SeverinDavis/sevmode-kl46z/README.txt

This is a Subversion repository; use the 'svnadmin' tool to examine
it.  Do not add, delete, or modify files here unless you know how
to avoid corrupting the repository.

Visit http://subversion.apache.org/ for more information.
