SeverinDavis/sevmode-kl46z/Drawings/top_drawing.png

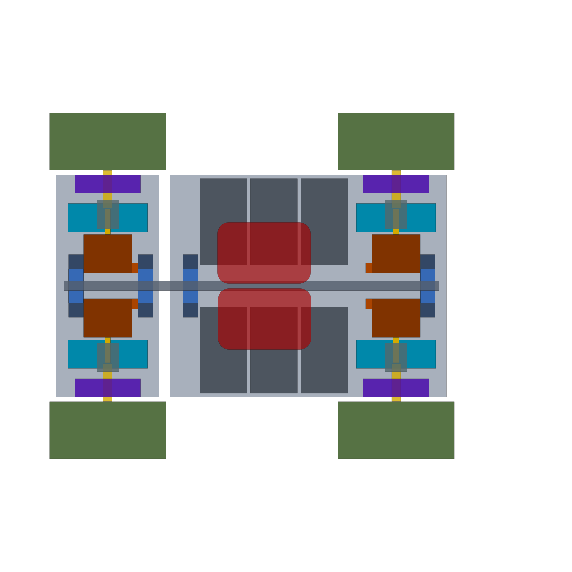
Drawings/top_drawing.png
