SeverinDavis/sevmode-kl46z/Kicad/car_v3.kicad_pcb

## KiCad design Kicad/car_v3.kicad_pcb (2014-08-28)

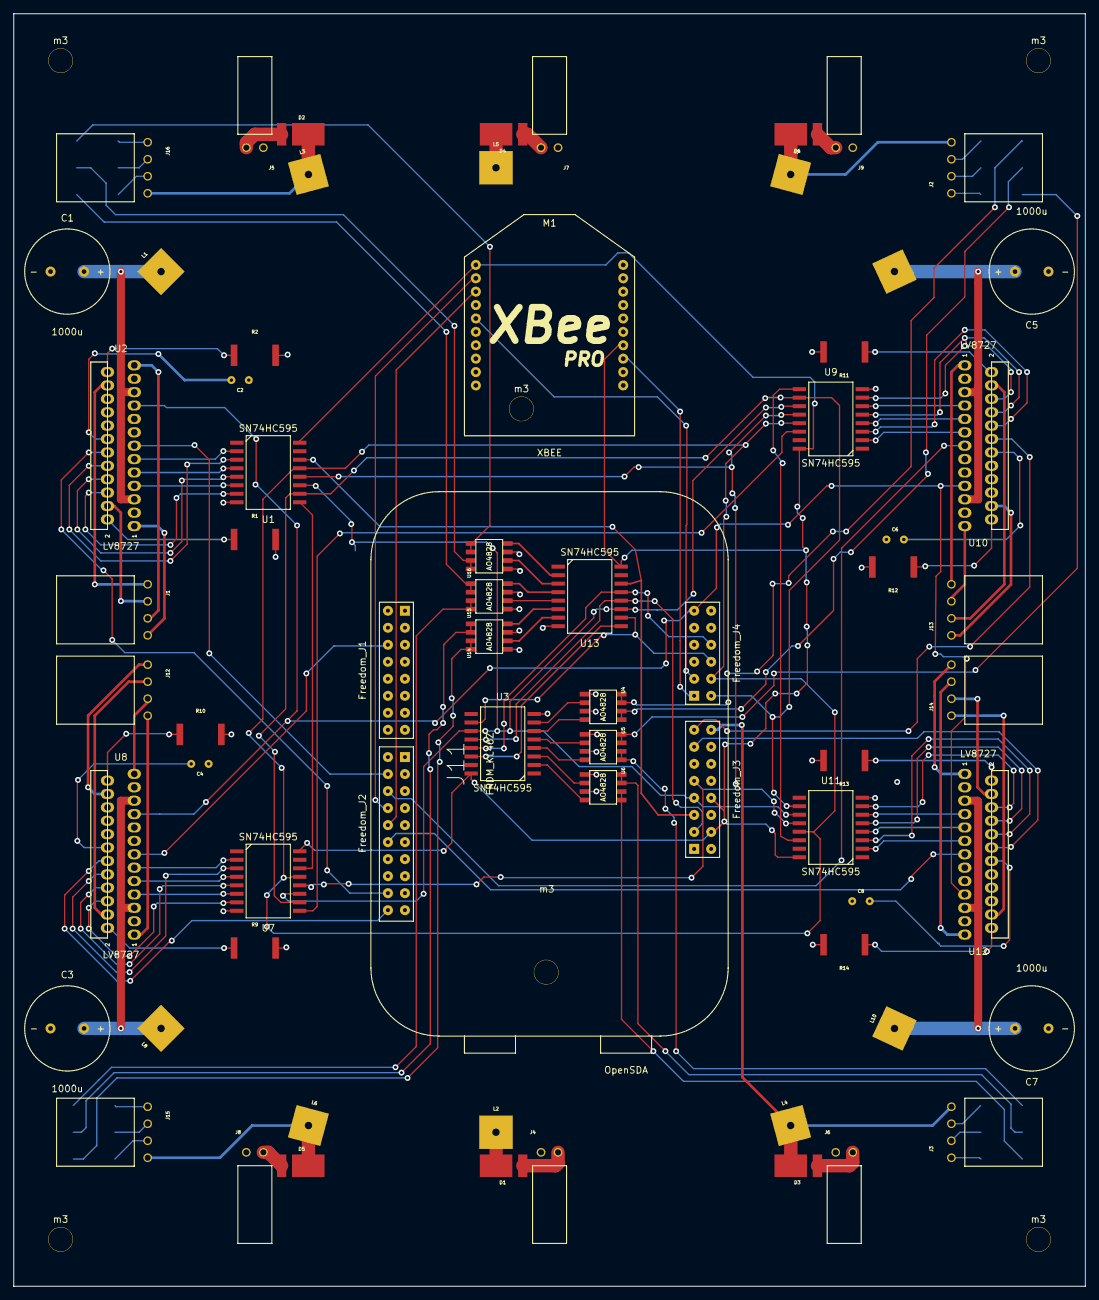
[picture p20: board car_v3.kicad_pcb from above]

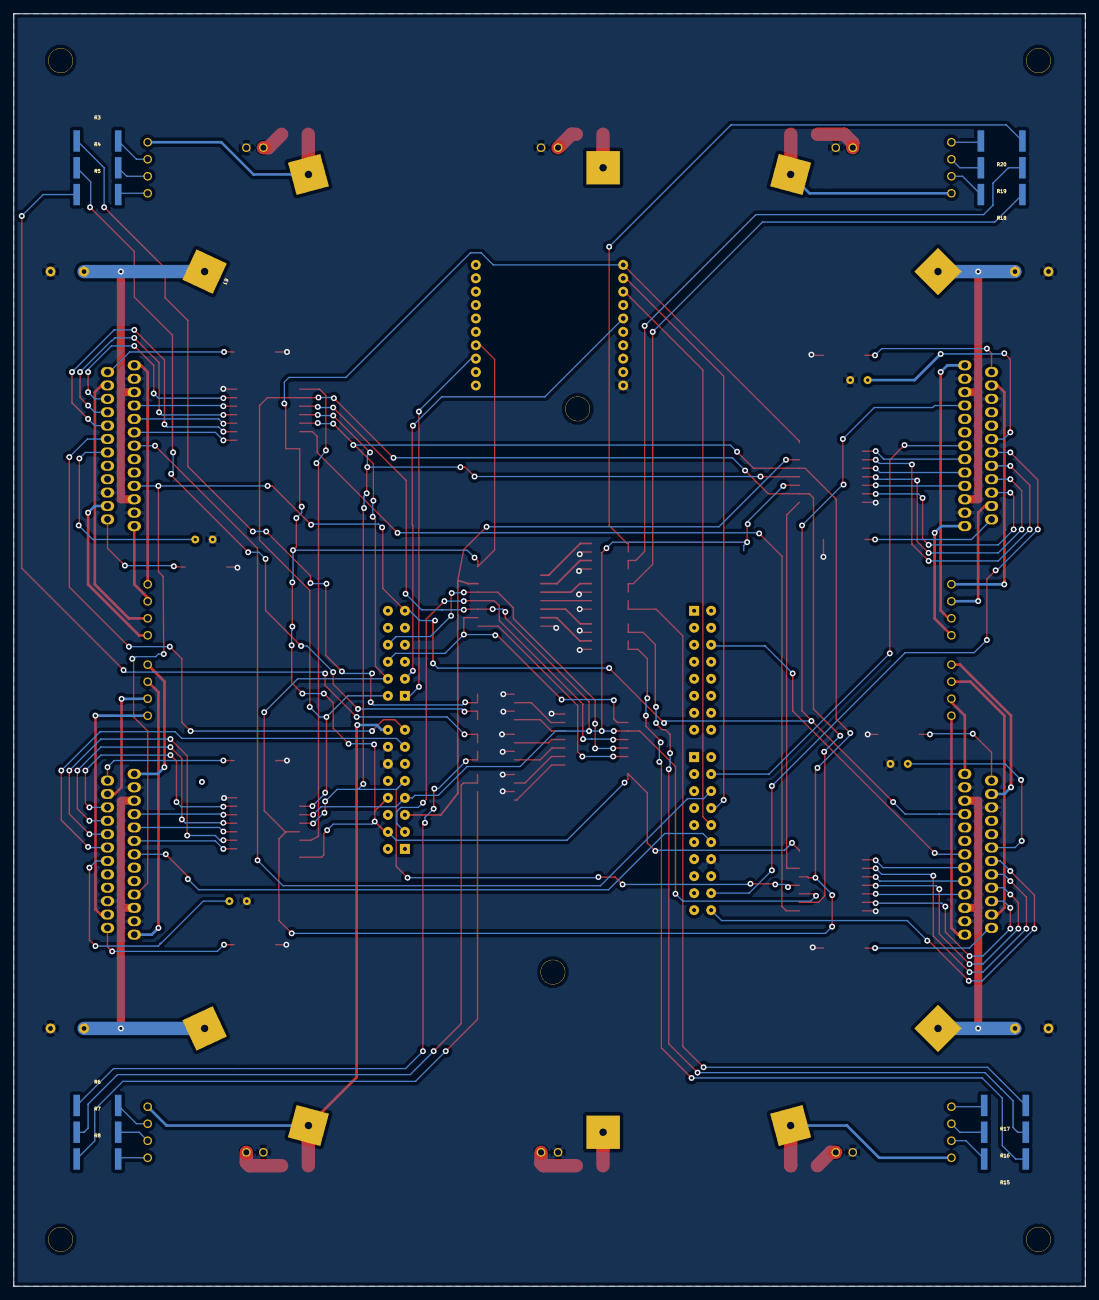
[picture p21: board car_v3.kicad_pcb from below]

Board: 2 copper layers, 160.0 x 190.0 mm, 82 parts (13 on the bottom side), 126 nets.

Parts:
C1, C3, C5, C7: 1000u; CAP_1000uF
C2, C4, C6, C8: 180p; __CAP_180p
D1, D2, D3, D4, D5, D6: POWER_DIODE; __POWERDI5
J1, J12, J13, J14: CONN_MOTOR; __4P_CONNECTOR
J2, J3, J15, J16: CONN_LED; __4P_CONNECTOR
J4, J5, J6, J7, J8, J9: CONN2; __2P_CONNECTOR
J11: FRDM_KL46Z; __Freedom
L1, L2, L3, L4, L5, L6, L7, L8, L9, L10: LUG; __LUG
M1: XBEE; __XBeePro
R1, R2, R9, R10, R11, R12, R13, R14: 0.27; _RES
R3, R6, R15, R18: 300; _RES
R4, R5, R7, R8, R16, R17, R19, R20: 249; _RES
U1, U3, U7, U9, U11, U13: SN74HC595; __SN74HC595
U2, U8, U10, U12: LV8727; __LV8728
U4, U5, U6, U14, U15, U16: AO4828; __AO4828
m3, m3#2, m3#3, m3#4, m3#5, m3#6: __m3

Connections:
+3.3V: J11.304, J11.308, M1.1, M1.14, U1.16, U3.16, U7.16, U9.16, U11.16, U13.16
+8V: D1.2, D2.2, D3.2, D4.2, D5.2, D6.2, J2.1, J3.1, J11.316, J15.1, J16.1, L2.1, L3.1, L4.1, L5.1, L6.1, L7.1
/KL46Z_DUAL/L_OE_b: J11.408, U3.13, U13.13
/KL46Z_DUAL/L_SRCLR_b: J11.406, U3.10, U13.10
/KL46Z_DUAL/M0_STEP: J11.204, U2.13
/KL46Z_DUAL/M1_STEP: J11.106, U8.13
/KL46Z_DUAL/M2_STEP: J11.206, U10.13
/KL46Z_DUAL/M3_STEP: J11.212, U12.13
/KL46Z_DUAL/M_OE_b: J11.404, U1.13, U7.13, U9.13, U11.13
/KL46Z_DUAL/M_SRCLR_b: J11.402, U1.10, U7.10, U9.10, U11.10
/KL46Z_DUAL/M_VREF: J11.411, U2.19, U8.19, U10.19, U12.19
/KL46Z_DUAL/SCL: J11.307, U1.11, U3.11, U7.11, U9.11, U11.11, U13.11
/KL46Z_DUAL/SDATA: J11.305, U1.14, U13.14
/LED_DUAL_DRIVER0/CS: J11.303, U3.12, U13.12
/LED_DUAL_DRIVER1/SDIN: U3.14, U13.9
/MOTOR0/CS: J11.309, U1.12, U7.12, U9.12, U11.12
/MOTOR0/FR: J11.218, U2.12
/MOTOR1/FR: J11.220, U8.12
/MOTOR1/SDIN: U1.9, U7.14
/MOTOR2/FR: J11.315, U10.12
/MOTOR2/SDIN: U7.9, U9.14
/MOTOR3/FR: J11.313, U12.12
/MOTOR3/SDIN: U9.9, U11.14
/XBEE0/ON: J11.401, M1.13
/XBEE0/RESET_b: J11.403, M1.5
/XBEE0/RX: J11.208, M1.2
/XBEE0/TX: J11.210, M1.3
GND: C1.2, C2.2, C3.2, C4.2, C5.2, C6.2, C7.2, C8.2, J4.2, J5.2, J6.2, J7.2, J8.2, J9.2, J11.214, J11.312, J11.314, M1.10, R1.2, R2.2, R9.2, R10.2, R11.2, R12.2, R13.2, R14.2, U1.8, U2.3, U2.20, U2.23, U3.8, U4.1, U4.3, U5.1, U5.3, U6.1, U6.3, U7.8, U8.3, U8.20, U8.23, U9.8, U10.3, U10.20, U10.23, U11.8, U12.3, U12.20, U12.23, U13.8, U14.1, U14.3, U15.1, U15.3, U16.1, U16.3
unnamed: J1.1, U2.1
unnamed: C2.1, U2.14
unnamed: J1.3, U2.4
unnamed: U1.7, U2.6
unnamed: J1.2, U2.25
unnamed: J1.4, U2.22
unnamed: R2.1, U2.24
unnamed: U1.4, U2.9
unnamed: R1.1, U2.2
unnamed: U1.6, U2.7
unnamed: U1.5, U2.8
unnamed: U1.3, U2.10
unnamed: U1.2, U2.11
unnamed: C1.1, L1.1, U2.5, U2.21
unnamed: R7.1, U6.5, U6.6
unnamed: R3.1, U4.5, U4.6
unnamed: R4.1, U4.7, U4.8
unnamed: R8.1, U6.7, U6.8
unnamed: J3.3, R7.2
unnamed: J2.2, R3.2
unnamed: J2.3, R4.2
unnamed: J2.4, R5.2
unnamed: J3.2, R6.2
unnamed: J3.4, R8.2
unnamed: U3.2, U6.4
unnamed: U3.3, U6.2
unnamed: U3.4, U5.4
unnamed: U3.7, U4.2
unnamed: U3.6, U4.4
unnamed: U3.5, U5.2
unnamed: R5.1, U5.5, U5.6
unnamed: R6.1, U5.7, U5.8
unnamed: D1.1, J4.1
unnamed: D2.1, J5.1
unnamed: D3.1, J6.1
unnamed: D4.1, J7.1
unnamed: D5.1, J8.1
unnamed: D6.1, J9.1
unnamed: J12.3, U8.4
unnamed: J12.1, U8.1
unnamed: C4.1, U8.14
unnamed: C3.1, L8.1, U8.5, U8.21
unnamed: U7.7, U8.6
unnamed: J12.2, U8.25
unnamed: J12.4, U8.22
unnamed: R10.1, U8.24
unnamed: U7.3, U8.10
unnamed: R9.1, U8.2
unnamed: U7.6, U8.7
unnamed: U7.5, U8.8
unnamed: U7.4, U8.9
unnamed: U7.2, U8.11
unnamed: J13.3, U10.4
unnamed: J13.1, U10.1
unnamed: C6.1, U10.14
unnamed: J13.2, U10.25
unnamed: J13.4, U10.22
unnamed: U9.7, U10.6
unnamed: R12.1, U10.24
unnamed: U9.5, U10.8
unnamed: R11.1, U10.2
unnamed: U9.6, U10.7
unnamed: U9.4, U10.9
unnamed: U9.3, U10.10
unnamed: U9.2, U10.11
unnamed: C5.1, L9.1, U10.5, U10.21
unnamed: J14.3, U12.4
unnamed: J14.1, U12.1
unnamed: C8.1, U12.14
unnamed: U11.7, U12.6
unnamed: J14.2, U12.25
unnamed: J14.4, U12.22
unnamed: R14.1, U12.24
unnamed: U11.5, U12.8
unnamed: R13.1, U12.2
unnamed: U11.6, U12.7
unnamed: U11.4, U12.9
unnamed: U11.3, U12.10
unnamed: U11.2, U12.11
unnamed: C7.1, L10.1, U12.5, U12.21
unnamed: R15.1, U14.5, U14.6
unnamed: R16.1, U14.7, U14.8
unnamed: R19.1, U16.5, U16.6
unnamed: R20.1, U16.7, U16.8
unnamed: J15.2, R15.2
unnamed: J15.3, R16.2
unnamed: J15.4, R17.2
unnamed: J16.2, R18.2
unnamed: J16.3, R19.2
unnamed: J16.4, R20.2
unnamed: U13.2, U16.4
unnamed: U13.3, U16.2
unnamed: U13.4, U15.4
unnamed: U13.7, U14.2
unnamed: U13.6, U14.4
unnamed: U13.5, U15.2
unnamed: R17.1, U15.5, U15.6
unnamed: R18.1, U15.7, U15.8
