SeverinDavis/sevmode-kl46z/Project_Headers/derivative.h

/*
 * Note: This file is recreated by the project wizard whenever the MCU is
 *       changed and should not be edited by hand
 */

/* Include the derivative-specific header file */
#include <MKL46Z4.h>
