SeverinDavis/sevmode-kl46z/(commit log)

2014-05-11 uc_lptmr.c should work.
    Some weirdness in uc_lptmr_delay:
    Sometimes LED just gets stuck on. Works after power cycling board. So it might be a reset issue or some logic problem.
    [main.c, uc_lptmr.c]
2014-06-08 All wired. ERC passes with no errors. Might be good to go.
    [BATTERY.sch, KL46Z_DUAL.sch, LED_DUAL_DRIVER.sch, MOTOR_DRIVER.sch, XBEE.sch, car_v3.sch]
2014-06-08 added lines for m_srclr_b, l_srclr_b, and m_oe_b and l_oe_b. woooot.
    [car_v3.sch]
2014-06-19 gpio buggy bug fixed. Also spi1 is semi-usable now. should be. maybe. i think.
    [gpio.c, main.c, uc_spi.c, uc_spi.h]
2014-06-21 output compare sort of working. uart source and header added.
2014-07-27 pcb seems about done.
    [car_v3.kicad_pcb]
2014-08-06 pcb routing. choo choo. chugging along.
    [car_v3.kicad_pcb]
2014-08-06 shoot me plz. so many traces...
    [car_v3.kicad_pcb]
2014-08-08 All aboard the choo choo shoe.
    [car_v3.kicad_pcb]
2014-08-09 pcb might be done.
    [car_v3.kicad_pcb]
2014-09-01 Added Visual Studio project with prototype xbox controller/serial port code.
2014-10-13 LED code moved to CAR_LED.c. Not tested yet, but no reason to suspect it wouldn't.
    CAR_MOTOR.c created. Need to copy over code currently in main and plop it into here.
    Also, Kill Paris is pretty dope. Especially at 2:46 AM.
2014-11-01 No longer need dummy sends to get SPI working. Fixed! WOOOO! Motor drivers next!
    [CAR_LED.c, main.c, uc_spi.c]
2014-11-01 motor shift registers should be working now. just need to make the setters.
2014-11-02 filling in more motor driver functions
2014-11-02 motor_startup written and seems to work. need to add and test dac
2014-11-02 dac hardcoding switched to lower current output.
2014-11-09 starting to build xbee/uart stuff
2014-11-14 untested UART and xbee. Some change just caused UART callback to happen, but I don't know what.
2014-11-16 UART working!!! OSR bits in the baud rate denominator weren't being factored in! DUH! #SHREKT
2014-11-26 trying to get pin interrupts on portc and d working.
2014-12-02 button interrupts working w/ example
2014-12-03 stepper motor demo.
2014-12-25 switching to lookup table acceleration and deceleration.
2014-12-27 rewrote motor callback
2014-12-28 direction reversal working, I think. Next: wakeup high period for fast response.
    [CAR_MOTOR.c, CAR_MOTOR.h, main.c]
2015-01-20 moving motor wakeup functionality to tpm channel 1.
2015-01-25 Host can send packets to vehicle now. AFAIK packets are assembled correctly at vehicle, but needs confirmation.
    [CAR_MOTOR.c, main.c, main.cpp, uc_tpm.c, uc_tpm.h]
2015-01-25 fix uart priority
2015-02-08 couple of little tweaks
2015-03-04 added failure tolerance on XBee
    [CAR_MOTOR.c, main.c, main.cpp]
2015-04-10 i2c
    adding i2c files
2015-04-10 deleted i2c
